zjm54321/ch552-pedal/hardware/测试用.stl

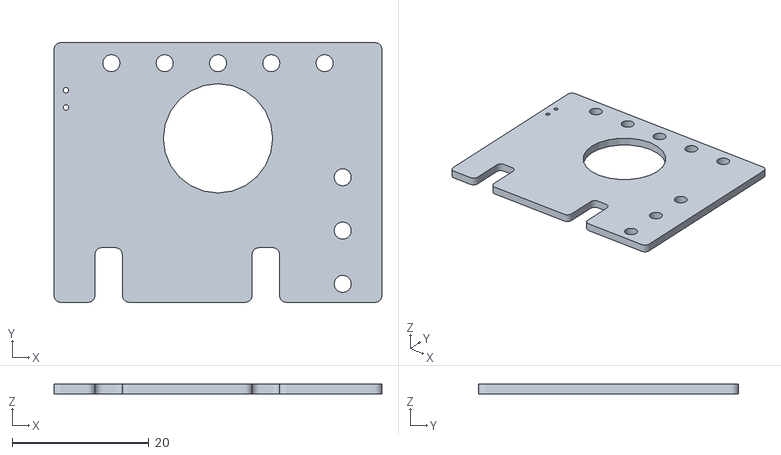
[picture p1: CAD file, 2026-11-09]
hardware/测试用.stl
48.0 x 38.0 x 1.51
