zjm54321/ch552-pedal/docs/verification.md

# 验证范围

## 接受条件和证据

| 行为 | 最小证据 | 验证责任 |
|---|---|---|
| 环境独立 | 此目录的锁定 flake 可进入，SDCC / Make / 烧录工具版本可查 | 工具链实现者 |
| 固件可用于目标芯片 | 实际 SDCC 链接、HEX 生成、Flash 不越过 `0x3800`，USB buffer 与 XRAM 不冲突 | 固件实现者；主会话集成复核 |
| VIA 改键 | 协议响应、大小端、矩阵坐标、buffer 长度、非法请求和未知命令的主机测试 | 协议实现者 |
| 组合键 | 普通键、左右修饰键组合、按下/松开、按住时改键的成对报告测试 | 按键逻辑实现者 |
| 持久化 | 保存、重启读取、空白/损坏配置、无变化不重复写入的逻辑测试 | 持久化实现者 |
| 踩住上电进 ISP | 源码路径独立于键位加载；上电输入稳定判断；实物拔插验证 | 固件实现者；用户实物验收 |
| 双设备不串改 | 实机同时授权两块，分别改键并读回，两个设备分别输出和松开 | 用户实物验收 |
| 浏览器端可用 | 当前 VIA 加载匹配定义后识别、改键、读回，断电仍保持 | 用户实物验收 |

## 边界

未连接实物时，构建和逻辑测试不能替代 USB 枚举、ISP 或双设备网页联调。
任何烧录操作都需要明确选择设备和用户授权；默认构建、检查不访问 USB 设备。
沿用同一候选代码的有效证据，集成后只补齐受修改影响的检查。

## 2026-11-03 首版结果

已执行 `nix develop path:. --no-write-lock-file --command make check`，退出码 **0**。
详细日志在 `build/verification.log`，目标审计在 `build/ch552/bounds.txt`。

- 主机断言通过：按键及左右修饰键组合、VIA 版本/命令/大小端、非法长度和
  坐标、buffer 边界及部分写入、CRC 记录与重启读取、按住时改键和释放、
  两个独立核心实例的状态隔离。
- SDCC 4.6.0 已生成真实 CH552 固件。最终检查复用未更改源码的构建产物，
  再审计其内容：8,463 字节有效 Flash 数据，最高地址 `0x2146`，
  低于 ISP 起点 `0x3800`。HEX 不含 bootloader、芯片配置或 DataFlash 数据。
- 端点 DMA 固定占用至字节 265；应用 XRAM 使用 330 字节，
  地址 `0x010A..0x0254`（末端不含），总占用未超出 1 KiB。
- 链接后的 reset、Timer2、USB 向量均指向实际代码；键盘和 Raw HID
  描述符、端点大小与 VIA VID/PID 一致。
- 栈从 `0x3E` 开始，链接器留下 194 字节空间；这是静态布局，非运行时峰值。
- 上游四个支持头文件及 LGPL 文本逐字节比较一致；本地改动有来源记录。
- `pedal.hex` SHA-256：
  `be7f4cdd47dbb0698913d8a522a6afb58a77dfeb3c9302e15dad6eec64fc9ea7`。

**尚未进行实物烧录或 USB 联调。** 以下作为实物验收步骤：

1. 首次通过既有硬件 ISP 入口刷入；普通插 USB 时确认出现键盘与 VIA 接口。
2. 在 VIA 导入 `via/pedal.json`，设为 Ctrl+Shift+K，确认按下及松开成对，
   拔插后仍保留。按住时改成另一个键，检查松开无卡键、下次踩下使用新键。
3. 将映射设为 `KC_NO`，断电，踩住再插 USB，确认仍出现 WCH ISP，
   并且仅进入/退出 ISP 不改变此前保存的键位。
4. 同时连接两块设备，确认产品名后缀不同、能分别选择；分别设 F13/F14，
   读回并单独及同时踩踏，确认没有串改。
5. 若刷入或后续升级失败，使用现有硬件 ISP 入口恢复；升级前备份配置。

## 2026-11-09 审查修复后结果

已执行 `make clean` 后再执行
`nix develop path:. --no-write-lock-file --command make check`，退出码 **0**。

- 修复内容：SET_REPORT 状态阶段、Raw HID 取请求的 epoch 竞争、唤醒时误清中断标志、
  键位改为双槽日志（新槽校验后才发布）、端点 halt 状态、休眠期间不补发按键、
  检查脚本校验完整键盘描述符。
- 新增主机测试：`tests/board/test_storage.c`（假 Flash，每一步写入故障和断电）、
  `tests/board/test_usb.cpp`（用模拟 SFR 编译实际的 `USBhandler.c` 和
  `usb_transport.c`）、`tests/test_check_firmware.py`（描述符变异）。
- 变异验证：逐项回退 SET_REPORT 状态、取请求 epoch 检查、唤醒标志清除、GET_STATUS、
  发送时的 halt 检查、活动槽保护、提交前校验，共 7 项，测试均失败（退出码 2）。
  验证在临时副本中进行。
- 8051 目标：10,028 字节有效 Flash 数据，最高地址 `0x2763`，低于 `0x3800`；
  XRAM 末端 `0x0290`；栈从 `0x4A` 开始，链接器留下 182 字节（静态布局，非运行时峰值）。
- `pedal.hex` SHA-256：
  `eedca170c4554a813acda27fd66f00bfbff47d4d29aab0d46eae6feb1b3ae8a6`。

主机测试用 C++ 代理模拟寄存器，证明的是状态机逻辑，不等于真实芯片的 USB 时序。
（此阶段为协议 8 中间审查版本，低功耗挂起尚未实现，见后文。）
同日早先使用 WCHISPTool（Bootloader 2.50，JP1 硬件引导正常）完成首个协议 8 版本实物刷入，
枚举为每芯片唯一的“Pedal 95BA7575BF”，并完成基础改键验证。

## 2026-11-09 VIA 协议 13、宏、掉电、双 USB ID 版本

已执行 `make clean` 后再执行
`nix develop path:. --no-write-lock-file --command make check`，退出码 **0**。

- 内容：VIA 协议 13 与 V3 定义；4 个 VIA 宏槽（109 字节共用）；USB 休眠进入 PD，只允许
  USB 唤醒；`test` 与 `is0` 两个版本，只有 VID/PID 不同。
- 主机测试：协议回复和宏命令边界、宏播放、宏存储（62 个写入位置、63 个断电点）、
  模拟 SFR 下的 PD 进入条件和唤醒恢复、两个版本的描述符变异。
- 独立复核：6 个变异中 5 个被测试抓到（PD 忽略总线状态、PD 启用脚踏唤醒、点按不释放、
  宏加载不校验 CRC、宏写入顺序不校验）；“中止不清 held”未被抓到，属等价变异，
  因为 `pedal_macro_start` 会清零 held。ASCII 表逐字符核对 97 个美式键位，无差异。
- 两个版本：13,651 字节有效 Flash 数据，最高地址 `0x358A`（低于 `0x3800`，余 629 字节）；
  XRAM 末端 `0x0358`；栈 187 字节（静态布局，非运行时峰值）。
- SHA-256：
  - `pedal-test.hex`：`520f1651914c560084d1e4b1c4193ef9fbf533c7ff0a3ec8444a43ffc4d741c0`
  - `pedal-is0.hex`：`f7660f2ced2ff6ba8421b5c800c23f629b85cac79de521e5a8add22798707c2a`

## 2026-11-09 硬件实物验收（v1.0.0 发布版）

2026-11-09，用户在实物单板上刷入协议 13 完整固件包，按照验证指引完成全套上机测试，所有步骤均反馈“正常”。

- **刷机与硬件引导**：通过 Windows 下 WCHISPTool（目标芯片 CH552，Bootloader 2.50，USB 接口，勾选目标程序文件1，下载配置脚 P3.6，不点击校验）烧录。首次通过板上 JP1 跳线进入 ISP 成功刷入。
- **设备枚举**：系统正常识别为 USB 键盘与 Raw HID 复合设备，设备产品名与序列号均为芯片 40 位 UID 派生的 `Pedal 95BA7575BF`。
- **VIA 13 连接与识别**：Chrome / Edge 打开 VIA 网页端，`is0` 变体由官方内置 is0 键盘定义自动匹配识别并展示单键布局；`test` 变体通过关闭“Use V2 definitions”手动加载 `via/pedal.json` 识别。
- **改键与断电持久化**：测试普通键、组合键（Ctrl+Shift+K 等）写入及读回，拔插断电后键位完好保持（DataFlash 双槽日志保证）。
- **按键与组合键逻辑**：普通按键与修饰键组合输出成对按下与释放，按住期间改键不产生卡键。
- **宏功能（VIA V11）**：宏界面录入文本与延时、保存、播放均正常；超长宏被 VIA 按设备报告的缓冲区大小拒绝，未写坏既有宏；断电重启后宏内容保持。
- **USB 挂起与恢复**：主机进入睡眠后固件进入 PD 低功耗模式；唤醒后无需重新枚举立即恢复正常输入，挂起期间无卡键或多余击键重播。
- **踩住上电进 ISP**：拔出 USB 后踩住脚踏插入，设备稳定进入 WCH bootloader，且此前保存的键位与宏均未丢失。

**测试范围边界记录**：
1. **验收来源**：本次实物测试结果来自用户的实操报告（“测试都正常”），未逐项提供日志或截图。
2. **挂起电流**：因用户未提供 USB 电流表量测数值，约 0.3 mA 释放 / 0.37 mA 踩下的挂起电流仍为数据手册理论估算值，无仪表实测记录。
3. **双设备同时使用**：两台脚踏同时插入并独立改键/使用的场景未在本次实物中单独测试与报告。
