zjm54321/ch552-pedal/(commit log)

2026-11-03 chore: bootstrap standalone CH552 pedal project
    Pin the SDCC development shell independently of the system configuration. Record the VIA, chord, bootloader and multi-device acceptance contract with GPL-3.0-or-later licensing.
2026-11-09 feat(firmware): add CH552G pedal firmware with VIA remapping
    USB keyboard plus Raw HID VIA protocol 8 on a pinned CH55xduino USB stack,
    built with SDCC from the local flake. A pedal held at power-up enters the WCH
    bootloader before any keymap read. Mappings persist in a two-slot DataFlash
    journal that survives power loss at every write step.
    Host tests cover keycodes, VIA bounds, persistence fault injection and the USB
    handler state machine against modelled SFRs. Hardware tested on one board:
    flashing, enumeration, VIA remapping.
2026-11-09 feat(hardware): publish KiCad design under CERN-OHL-S-2.0
    Snapshot of the schematic, PCB and CH552G library so the project meets the
    pid.codes open hardware requirement, plus the PID 1209:C552 request draft.
    The firmware keeps the shared 1209:0001 test pair until that request is approved.
    [测试用.stl, 脚踏开关.kicad_pcb, 脚踏开关.kicad_sch]
2026-11-09 feat(firmware): add VIA protocol 13, macros, suspend power-down and is0 build
    Moves to VIA protocol 13 with a V3 definition, adds four V11 macros in a
    109-byte DataFlash buffer with CRC-checked publication, and powers down during
    USB suspend with USB-only wake. Builds test (1209:0001) and is0 (A103:0012)
    images from one source tree; neither ID is allocated to this project.
    Host tests and link audits pass. None of this has run on hardware yet.
2026-11-09 docs: describe both USB ID variants and withdraw the pid.codes request
    States where each ID comes from, that both builds are private-use only, and
    what remains to be verified on hardware.
2026-11-09 docs: update all documentation for v1.0.0
    Records the 2026-11-09 hardware acceptance as reported by the user, the
    WCHISPTool flashing steps, both USB ID variants and their limits, and adds a
    changelog and release notes. Suspend current remains a datasheet estimate.
